KepecsLab/Bpod_r0_5/CAD/Mouse behavior box/Readme.txt

Note: This design for the mouse behavior box is undergoing validation.
It will almost certainly be revised many times in the coming year. A bill of materials is available on the Bpod wiki. JS, June 2015
