KepecsLab/Bpod_r0_5/CAD/Ports/Mouse nosepoke/Readme.txt

Note: The design for the mouse poke is optimized for 3-d printing.
However, mice eat PLA and possibly ABS. A future revision will feature a re-design optimized for machining. A bill of materials is available on the Bpod wiki. JS, June 2015
