KepecsLab/Bpod_r0_5/Bpod System Files/Internal Functions/Graphics/Bitmap/GrayBG.jpg

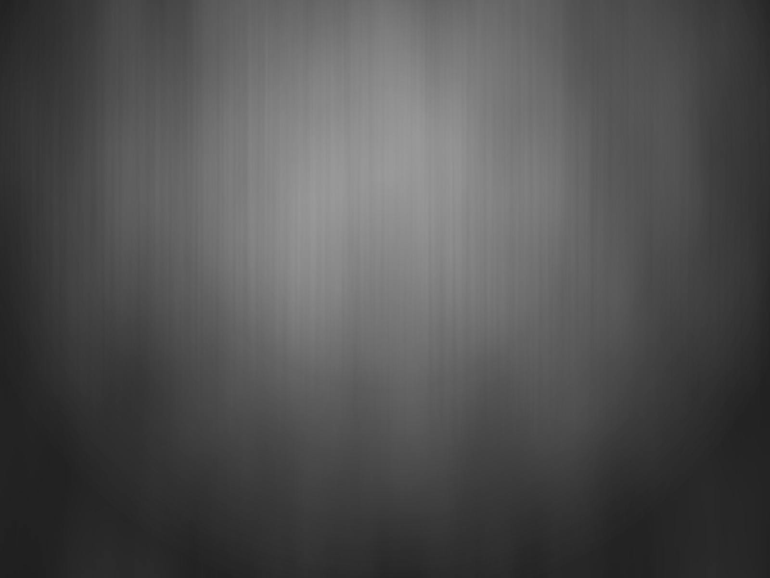
Bpod System Files/Internal Functions/Graphics/Bitmap/GrayBG.jpg
