KepecsLab/Bpod_r0_5/Bpod System Files/Internal Functions/Graphics/Bitmap/RewardCalAddRecommends.bmp

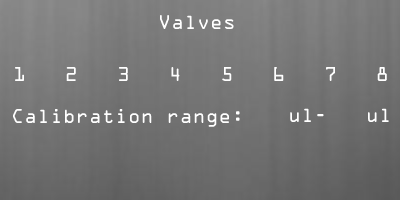
Bpod System Files/Internal Functions/Graphics/Bitmap/RewardCalAddRecommends.bmp
