KepecsLab/Bpod_r0_5/Bpod System Files/Internal Functions/Graphics/Bitmap/RewardCalEnterValue.bmp

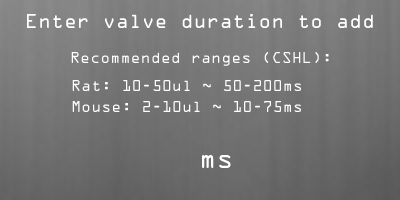
Bpod System Files/Internal Functions/Graphics/Bitmap/RewardCalEnterValue.bmp
