KepecsLab/Bpod_r0_5/Bpod System Files/Internal Functions/Graphics/Bitmap/SettingsMenuBG.bmp

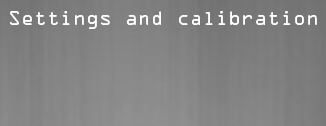
Bpod System Files/Internal Functions/Graphics/Bitmap/SettingsMenuBG.bmp
