KepecsLab/Bpod_r0_5/Bpod System Files/Internal Functions/Graphics/Bitmap/sm_bg.bmp

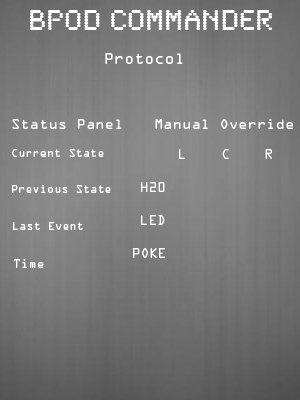
Bpod System Files/Internal Functions/Graphics/Bitmap/sm_bg.bmp
