KepecsLab/Bpod_r0_5/CAD/PCB/BpodDevice/Mouse.bmp

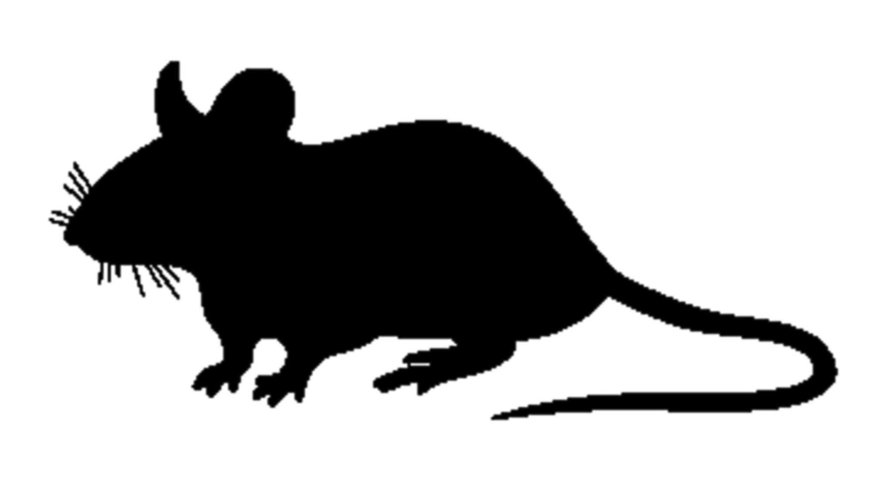
CAD/PCB/BpodDevice/Mouse.bmp
