KepecsLab/Bpod_r0_5/CAD/Ports/Lickometer/Lickometer.jpg

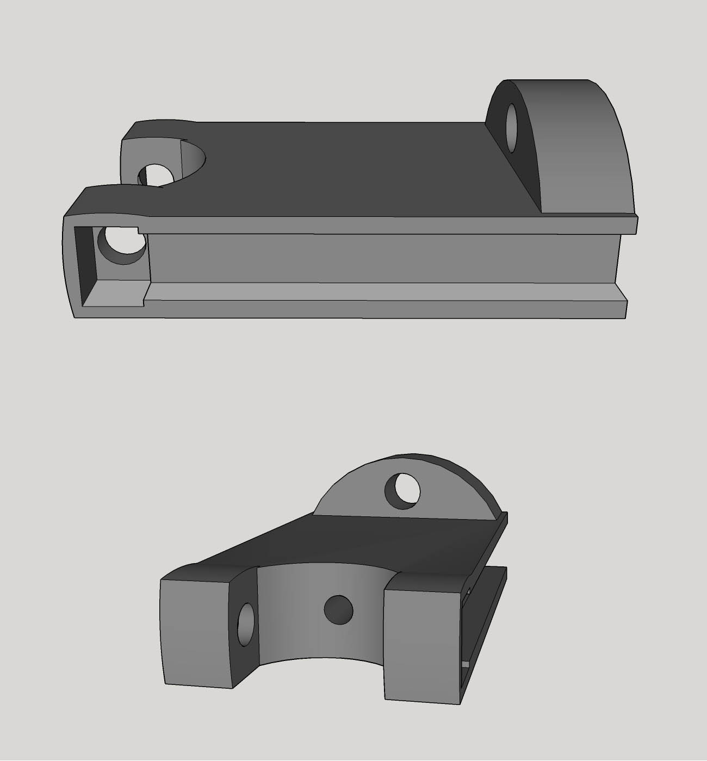
CAD/Ports/Lickometer/Lickometer.jpg
