KepecsLab/Bpod_r0_5/CAD/Mouse behavior box/2D DXF Laser Cut/Laser_Clear_3mm.dxf

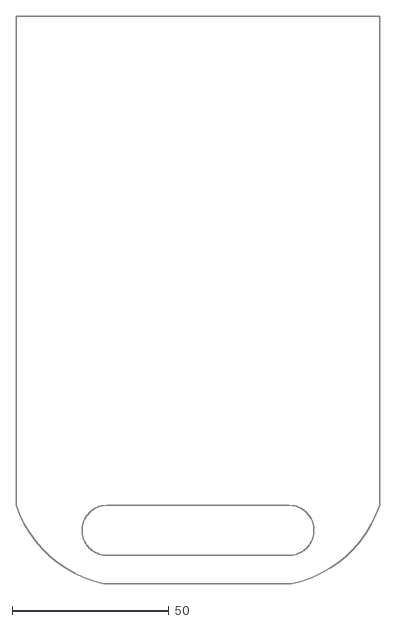
[picture p20: CAD file, 2015-06-29]
CAD/Mouse behavior box/2D DXF Laser Cut/Laser_Clear_3mm.dxf
116.0 x 181.0
