KepecsLab/Bpod_r0_5/CAD/Mouse behavior box/3D STL Print/MouseBox_3dPrint_Base.stl

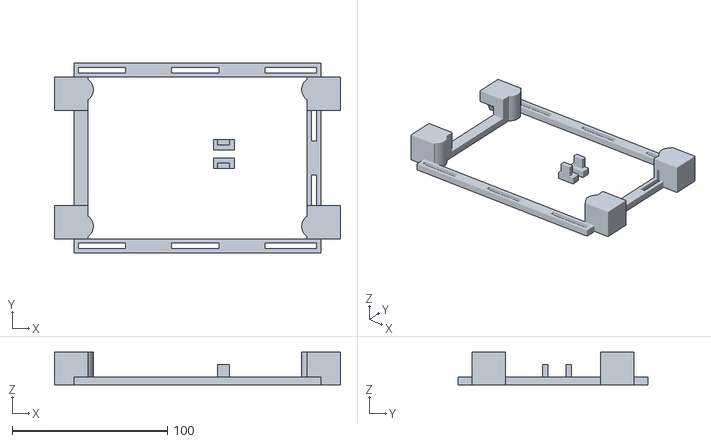
[picture p21: CAD file, 2015-06-29]
CAD/Mouse behavior box/3D STL Print/MouseBox_3dPrint_Base.stl
184.0 x 122.0 x 21.0
