KepecsLab/Bpod_r0_5/CAD/Ports/Lickometer/Lickometer.stl

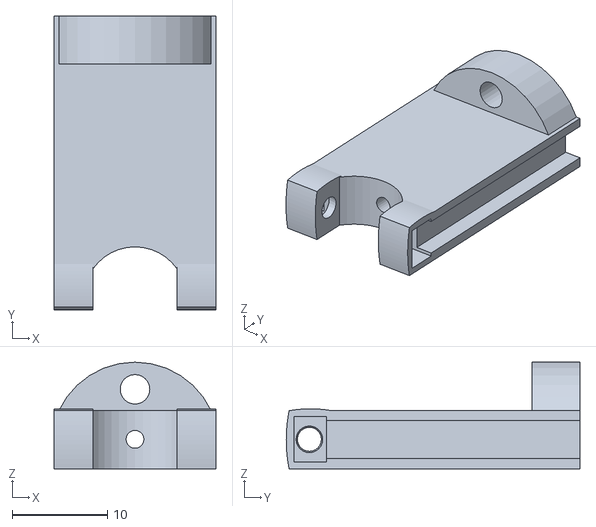
[picture p22: CAD file, 2014-11-01]
CAD/Ports/Lickometer/Lickometer.stl
17.0 x 30.8 x 11.2
