KepecsLab/Bpod_r0_5/CAD/Mouse behavior box/2D DXF Laser Cut/Laser_White_3mm.dxf

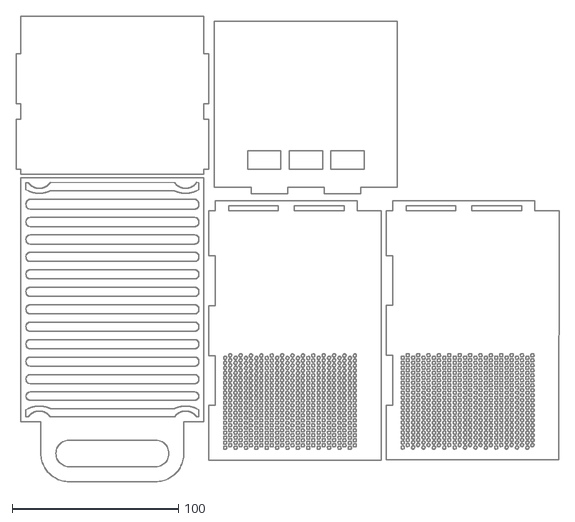
[picture p23: CAD file, 2015-06-29]
CAD/Mouse behavior box/2D DXF Laser Cut/Laser_White_3mm.dxf
326.7 x 280.0
