KepecsLab/Bpod_r0_5/CAD/Mouse behavior box/3D STL Print/MouseBox_3dPrint_Top.stl

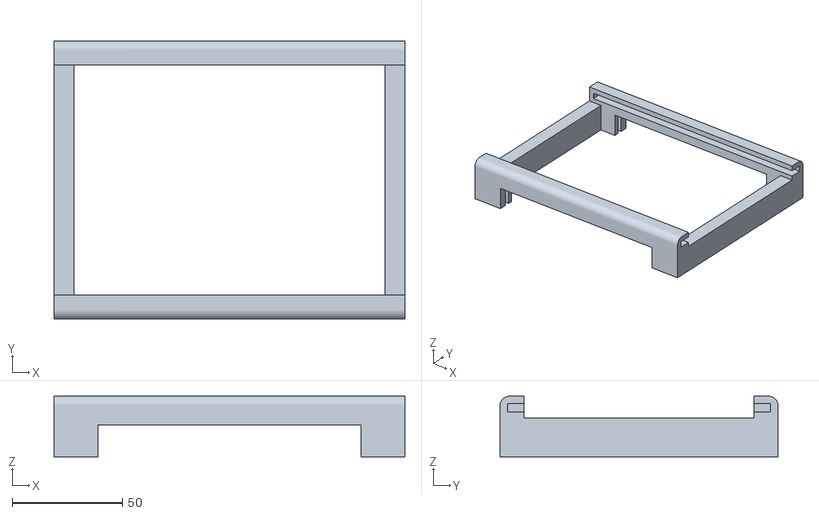
[picture p24: CAD file, 2015-06-29]
CAD/Mouse behavior box/3D STL Print/MouseBox_3dPrint_Top.stl
159.0 x 126.1 x 27.5
