KepecsLab/Bpod_r0_5/(list of files, cad)

Other CAD files:
CAD/Accessories/Open Ephys sync board/OpenEphysSyncBoardMount.skp
CAD/Ports/Lickometer/Lickometer.skp
CAD/Ports/Mouse nosepoke/Mousepoke_3dprint_PLA_Divider.skp
CAD/Ports/Mouse nosepoke/Mousepoke_3dprint_PLA_cover.skp
CAD/Ports/Mouse nosepoke/Mousepoke_3dprint_PLA_port.skp
CAD/Ports/Mouse nosepoke/Mousepoke_3dprint_PLA_sheath.skp
CAD/Ports/Mouse nosepoke/Mousepoke_InterfaceBoardMount.skp
