KepecsLab/Bpod_r0_5/CAD/PCB/MouseBoxPortBreakout/MouseBox_PortBreakout_r1.brd

## EAGLE design CAD/PCB/MouseBoxPortBreakout/MouseBox_PortBreakout_r1.brd (2015-07-06)

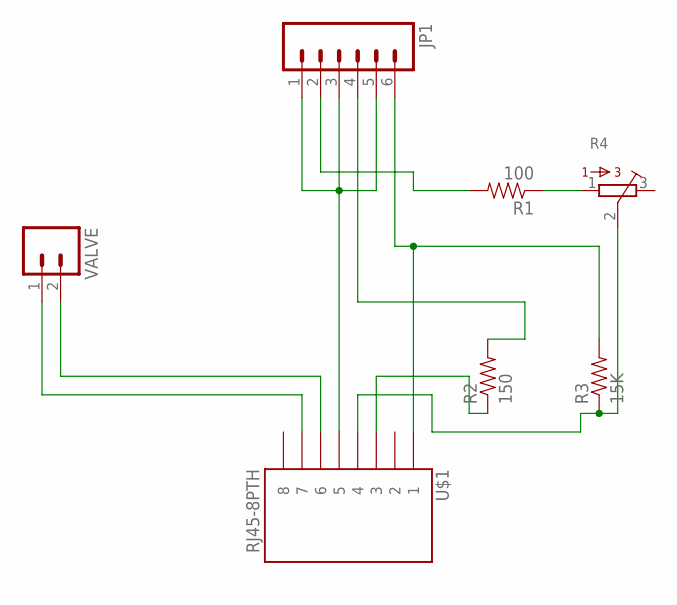
[picture p25: schematic MouseBox_PortBreakout_r1.sch]

Parts:
JP1: M063.5MM-6; SCREWTERMINAL-3.5MM-6
R1: 100; AXIAL-0.3
R2: 150; AXIAL-0.3
R3: 15K; AXIAL-0.3
R4: 3362R
U$1: RJ45-8PTH; RJ45-8
VALVE: M023.5MM_LOCK; SCREWTERMINAL-3.5MM-2_LOCK

Connections:
GND: JP1.1, JP1.3, JP1.5, U$1.5
unnamed: JP1.6, R3.P$2 (2), U$1.1
unnamed: R3.P$1 (1), R4.2, U$1.4
unnamed: JP1.2, R1.P$2 (2)
unnamed: U$1.6, VALVE.2
unnamed: U$1.7, VALVE.1
unnamed: JP1.4, R2.P$2 (2)
unnamed: R2.P$1 (1), U$1.3
unnamed: R1.P$1 (1), R4.1

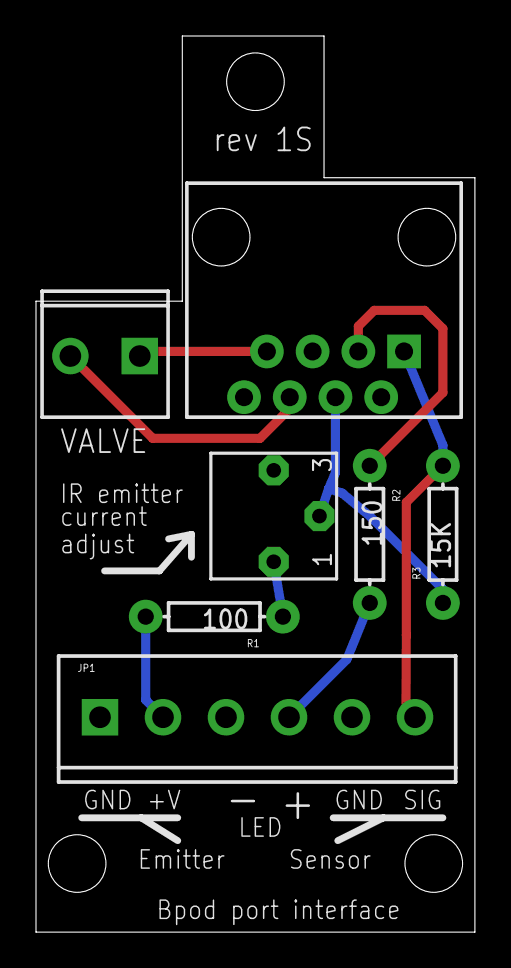
[picture p26: board MouseBox_PortBreakout_r1.brd from above]

Board: 2 copper layers, 24.4 x 49.8 mm, 7 parts (0 on the bottom side), 9 nets.
