KepecsLab/Bpod_r0_5/CAD/PCB/BpodDevice/BpodMainBoard_r0_5.brd

## EAGLE design CAD/PCB/BpodDevice/BpodMainBoard_r0_5.brd (2014-08-26)

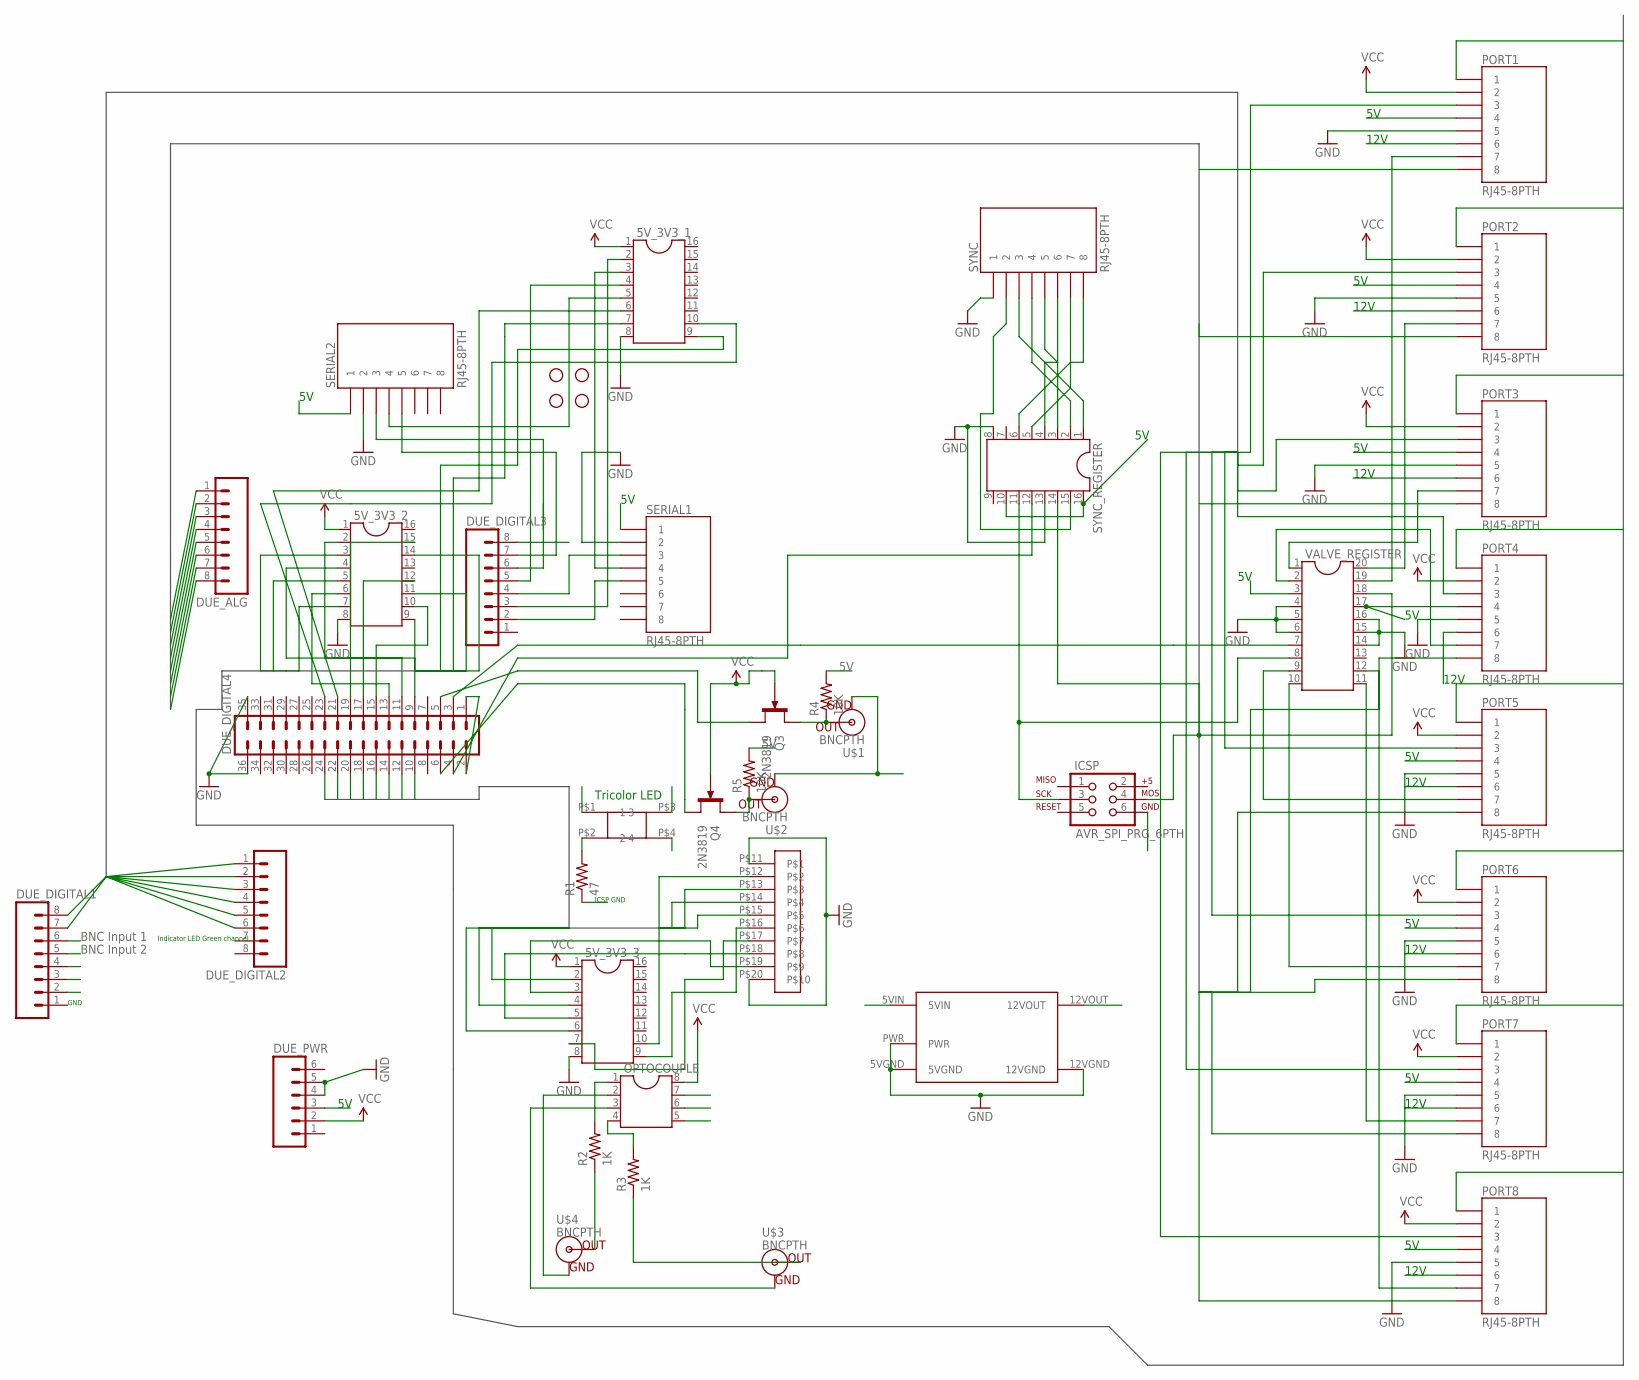
[picture p27: schematic BpodMainBoard_r0_5.sch]

Parts:
5V_3V3_1, 5V_3V3_2, 5V_3V3_3: DIL16
DUE_ALG: M081X08; 1X08
DUE_DIGITAL1, DUE_DIGITAL2, DUE_DIGITAL3: M081X08; 1X08
DUE_DIGITAL4: MA18-2
DUE_PWR: M06SIP; 1X06
ICSP: AVR_SPI_PRG_6PTH; 2X3
JP1, JP2, JP3, JP4: STAND-OFF
OPTOCOUPLE: DIL8; DIL08
PORT1, PORT2, PORT3, PORT4, PORT5, PORT6, PORT7, PORT8: RJ45-8PTH; RJ45-8
Q3, Q4: 2N3819; TO92F
R1: 47; AXIAL-0.3
R2, R3: 1K; AXIAL-0.3
R4, R5: 10K; AXIAL-0.3
SERIAL1, SERIAL2: RJ45-8PTH; RJ45-8
SYNC: RJ45-8PTH; RJ45-8
SYNC_REGISTER: DIL16
U$1, U$2, U$3, U$4: BNCPTH; BNC
U$5: TDK_LAMBDA_5V_TO_12V; TDK_LAMBDA_5V_12V
U$6: 10POS_SPRING_TERMINAL; 10POS_SCREW_TERMINAL
U$8: SQUARE_TRICOLOR_LED
VALVE_REGISTER: DIL20

Connections:
5V: DUE_DIGITAL4.1, DUE_DIGITAL4.2, DUE_PWR.3, PORT1.4, PORT2.4, PORT3.4, PORT4.4, PORT5.4, PORT6.4, PORT7.4, PORT8.4, R4.P$2 (2), R5.P$2 (2), SERIAL1.1, SERIAL2.1, SYNC_REGISTER.10, SYNC_REGISTER.16, U$5.5VIN, VALVE_REGISTER.3, VALVE_REGISTER.17
12V: PORT1.6, PORT2.6, PORT3.6, PORT4.6, PORT5.6, PORT6.6, PORT7.6, PORT8.6, U$5.12VOUT
ANALOG_BUS1: DUE_ALG.1, PORT1.8
ANALOG_BUS2: DUE_ALG.2, PORT2.8
ANALOG_BUS3: DUE_ALG.3, PORT3.8
ANALOG_BUS4: DUE_ALG.4, PORT4.8
ANALOG_BUS5: DUE_ALG.5, PORT5.8
ANALOG_BUS6: DUE_ALG.6, PORT6.8
ANALOG_BUS7: DUE_ALG.7, PORT7.8
ANALOG_BUS8: DUE_ALG.8, PORT8.8
BNCIN1: DUE_DIGITAL1.6, OPTOCOUPLE.7
BNCIN2: DUE_DIGITAL1.5, OPTOCOUPLE.6
DIGITAL_BUS1: 5V_3V3_2.3, PORT1.1
DIGITAL_BUS2: 5V_3V3_2.5, PORT2.1
DIGITAL_BUS3: 5V_3V3_2.7, PORT3.1
DIGITAL_BUS4: 5V_3V3_2.9, PORT4.1
DIGITAL_BUS5: 5V_3V3_2.11, PORT5.1
DIGITAL_BUS6: 5V_3V3_2.14, PORT6.1
DIGITAL_BUS7: 5V_3V3_1.7, PORT7.1
DIGITAL_BUS8: 5V_3V3_1.9, PORT8.1
DSUB_BUS1: 5V_3V3_3.2, DUE_DIGITAL4.10
DSUB_BUS2: 5V_3V3_3.4, DUE_DIGITAL4.12
DSUB_BUS3: 5V_3V3_3.6, DUE_DIGITAL4.14
DSUB_BUS4: 5V_3V3_3.10, DUE_DIGITAL4.16
DSUB_BUS5: DUE_DIGITAL4.18, U$6.P$15
DSUB_BUS6: DUE_DIGITAL4.20, U$6.P$14
DSUB_BUS7: DUE_DIGITAL4.22, U$6.P$13
DSUB_BUS8: DUE_DIGITAL4.24, U$6.P$12
GND: 5V_3V3_1.8, 5V_3V3_2.8, 5V_3V3_3.8, DUE_DIGITAL4.35, DUE_DIGITAL4.36, DUE_PWR.4, DUE_PWR.5, PORT1.5, PORT2.5, PORT3.5, PORT4.5, PORT5.5, PORT6.5, PORT7.5, PORT8.5, SERIAL1.2, SERIAL2.2, SYNC.1, SYNC_REGISTER.8, SYNC_REGISTER.13, U$5.5VGND, U$5.12VGND, U$5.PWR, U$6.P$11, U$6.P$20, VALVE_REGISTER.4, VALVE_REGISTER.5, VALVE_REGISTER.6, VALVE_REGISTER.14, VALVE_REGISTER.15, VALVE_REGISTER.16
ICSP_GND: ICSP.6, R1.P$1 (1)
LED1: DUE_DIGITAL1.4, U$8.P$3 (3)
LED2: DUE_DIGITAL1.3, U$8.P$4 (4)
LED3: DUE_DIGITAL3.8, U$8.P$1 (1)
LED_BUS1: DUE_DIGITAL1.7, PORT1.3
LED_BUS2: DUE_DIGITAL1.8, PORT2.3
LED_BUS3: DUE_DIGITAL2.1, PORT3.3
LED_BUS4: DUE_DIGITAL2.2, PORT4.3
LED_BUS5: DUE_DIGITAL2.3, PORT5.3
LED_BUS6: DUE_DIGITAL2.4, PORT6.3
LED_BUS7: DUE_DIGITAL2.5, PORT7.3
LED_BUS8: DUE_DIGITAL2.6, PORT8.3
unnamed: R2.P$1 (1), U$4.S (OUT)
unnamed: R3.P$1 (1), U$3.S (OUT)
unnamed: OPTOCOUPLE.1, R2.P$2 (2)
unnamed: OPTOCOUPLE.4, R3.P$2 (2)
unnamed: OPTOCOUPLE.2, U$4.GND
unnamed: OPTOCOUPLE.3, U$3.GND
unnamed: Q3.D, R4.P$1 (1), U$1.S (OUT)
unnamed: Q4.D, R5.P$1 (1), U$2.S (OUT)
unnamed: PORT1.7, VALVE_REGISTER.19
unnamed: PORT2.7, VALVE_REGISTER.20
unnamed: PORT3.7, VALVE_REGISTER.1
unnamed: PORT4.7, VALVE_REGISTER.2
unnamed: PORT5.7, VALVE_REGISTER.9
unnamed: PORT6.7, VALVE_REGISTER.10
unnamed: PORT7.7, VALVE_REGISTER.11
unnamed: PORT8.7, VALVE_REGISTER.12
unnamed: SYNC.2, SYNC_REGISTER.15
unnamed: SYNC.3, SYNC_REGISTER.1
unnamed: SYNC.4, SYNC_REGISTER.2
unnamed: DUE_DIGITAL4.3, VALVE_REGISTER.7
unnamed: SYNC.5, SYNC_REGISTER.3
unnamed: SYNC.6, SYNC_REGISTER.4
unnamed: SYNC.7, SYNC_REGISTER.5
unnamed: SYNC.8, SYNC_REGISTER.6
unnamed: R1.P$2 (2), U$8.P$2 (2)
unnamed: DUE_DIGITAL4.5, Q3.S
unnamed: DUE_DIGITAL4.4, SYNC_REGISTER.12
unnamed: DUE_DIGITAL4.6, Q4.S
unnamed: 5V_3V3_1.3, SERIAL1.4
unnamed: 5V_3V3_1.2, DUE_DIGITAL3.3
unnamed: DUE_DIGITAL3.4, SERIAL1.3
unnamed: 5V_3V3_1.5, SERIAL2.4
unnamed: 5V_3V3_1.4, DUE_DIGITAL3.5
unnamed: DUE_DIGITAL3.2, SERIAL1.5
unnamed: 5V_3V3_1.6, DUE_DIGITAL4.21
unnamed: DUE_DIGITAL3.6, SERIAL2.3
unnamed: 5V_3V3_1.10, DUE_DIGITAL4.23
unnamed: DUE_DIGITAL3.7, SERIAL2.5
unnamed: 5V_3V3_2.2, DUE_DIGITAL4.9
unnamed: 5V_3V3_2.4, DUE_DIGITAL4.11
unnamed: 5V_3V3_2.6, DUE_DIGITAL4.13
unnamed: 5V_3V3_2.10, DUE_DIGITAL4.15
unnamed: 5V_3V3_2.12, DUE_DIGITAL4.17
unnamed: 5V_3V3_2.15, DUE_DIGITAL4.19
unnamed: 5V_3V3_3.3, U$6.P$19
unnamed: 5V_3V3_3.5, U$6.P$18
unnamed: 5V_3V3_3.7, U$6.P$17
unnamed: 5V_3V3_3.9, U$6.P$16
SPI_CLK: ICSP.3, SYNC_REGISTER.11, VALVE_REGISTER.8
SPI_DATA: ICSP.4, SYNC_REGISTER.14, VALVE_REGISTER.18
UPPER_GND: DUE_DIGITAL1.2, OPTOCOUPLE.5, U$1.GND, U$2.GND
VCC: 5V_3V3_1.1, 5V_3V3_2.1, 5V_3V3_3.1, DUE_PWR.2, OPTOCOUPLE.8, PORT1.2, PORT2.2, PORT3.2, PORT4.2, PORT5.2, PORT6.2, PORT7.2, PORT8.2, Q3.G, Q4.G

Notes on the sheet:
12V
BNC Input 1
BNC Input 2
Indicator LED Green channel
Tricolor LED
ICSP GND
GND

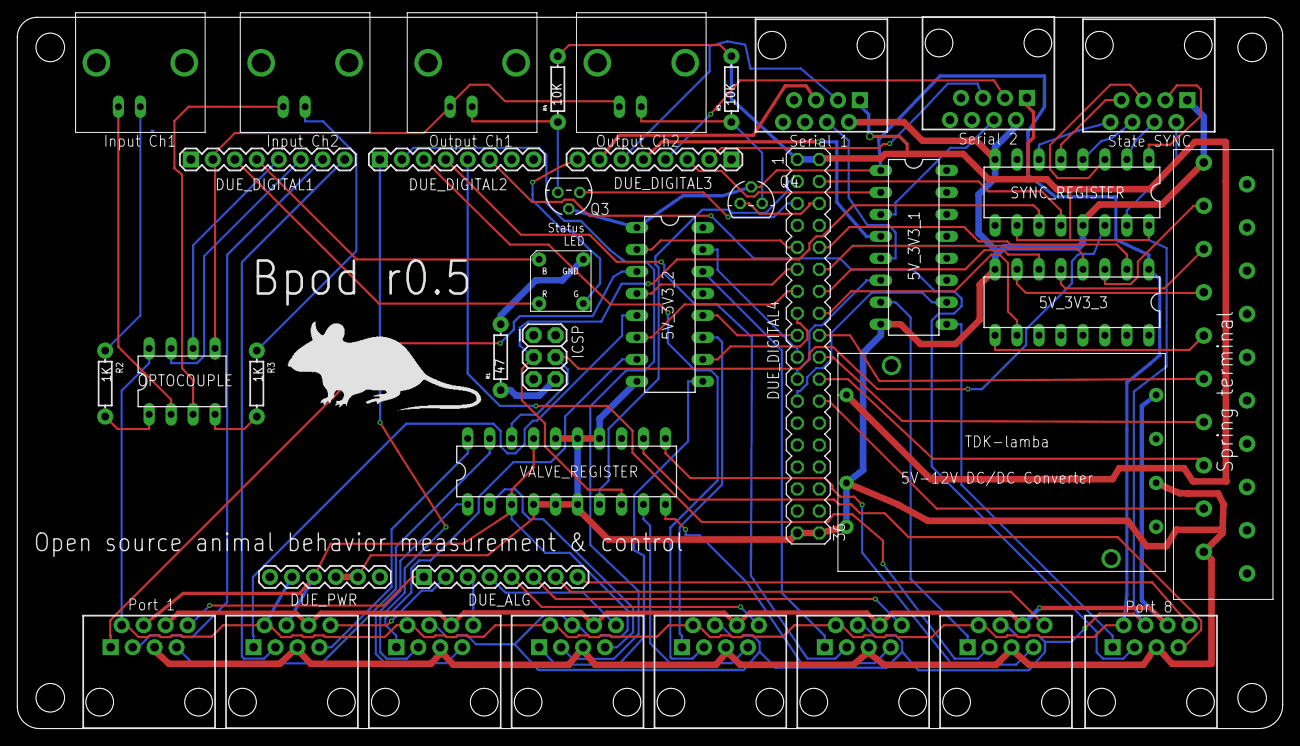
[picture p28: board BpodMainBoard_r0_5.brd from above]

Board: 2 copper layers, 146.3 x 82.2 mm, 43 parts (0 on the bottom side), 93 nets.

Other parts of the board:
U$7: MOUSELOGO
