KepecsLab/Bpod_r0_5/CAD/PCB/OpenEphysSync/io-board-Bpod.brd

## EAGLE design CAD/PCB/OpenEphysSync/io-board-Bpod.brd (2014-02-06)

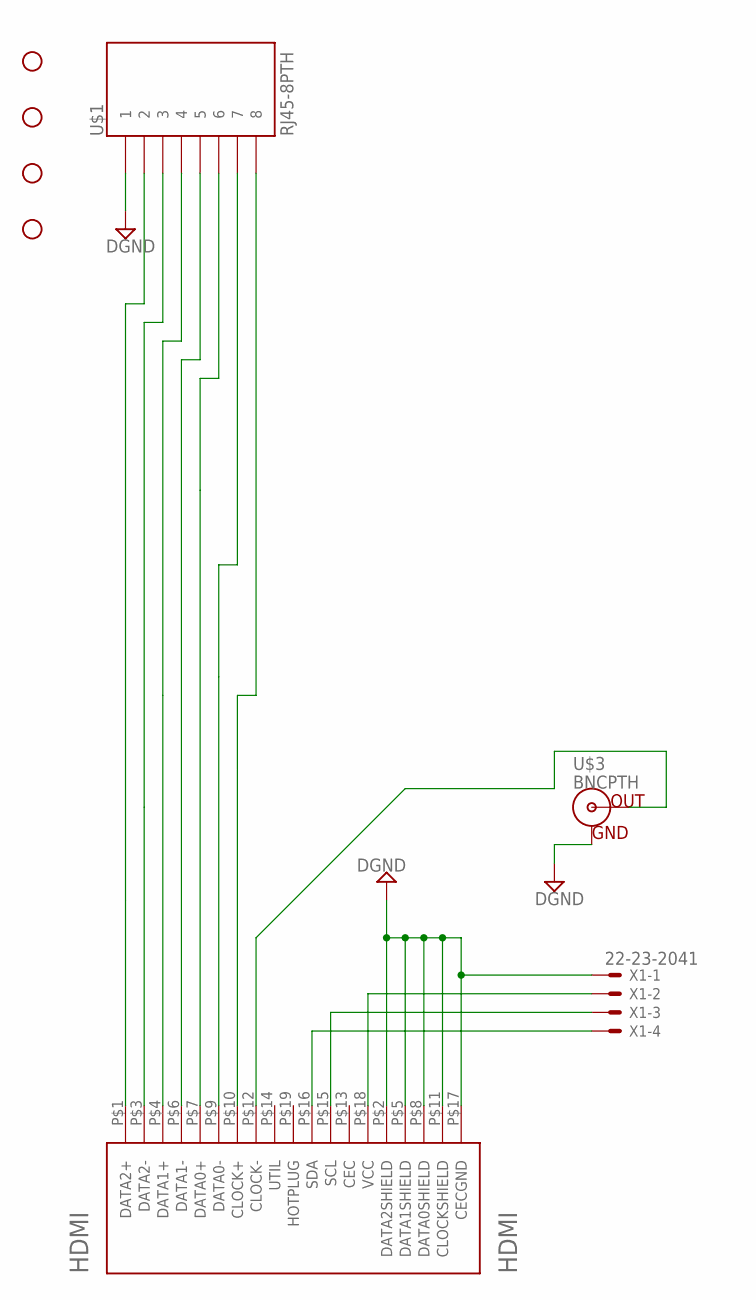
[picture p29: schematic io-board-Bpod.sch]

Parts:
HDMI: HDMI; HDMI_A
STANDOFF1, STANDOFF2, STANDOFF3, STANDOFF4: STAND-OFF
U$1: RJ45-8PTH; RJ45-8
U$3: BNCPTH; BNC
X1: 22-23-2041

Connections:
CH6: HDMI.P$9 (DATA0-), U$1.7
DGND: HDMI.P$2 (DATA2SHIELD), HDMI.P$5 (DATA1SHIELD), HDMI.P$8 (DATA0SHIELD), HDMI.P$11 (CLOCKSHIELD), HDMI.P$17 (CECGND), U$1.1, U$3.GND, X1.1
I2C_CLK: HDMI.P$15 (SCL), X1.3
I2C_DAT: HDMI.P$16 (SDA), X1.4
unnamed: HDMI.P$12 (CLOCK-), U$3.S (OUT)
unnamed: HDMI.P$4 (DATA1+), U$1.4
unnamed: HDMI.P$3 (DATA2-), U$1.3
unnamed: HDMI.P$1 (DATA2+), U$1.2
unnamed: HDMI.P$7 (DATA0+), U$1.6
unnamed: HDMI.P$10 (CLOCK+), U$1.8
unnamed: HDMI.P$6 (DATA1-), U$1.5
VCC: HDMI.P$18 (VCC), X1.2

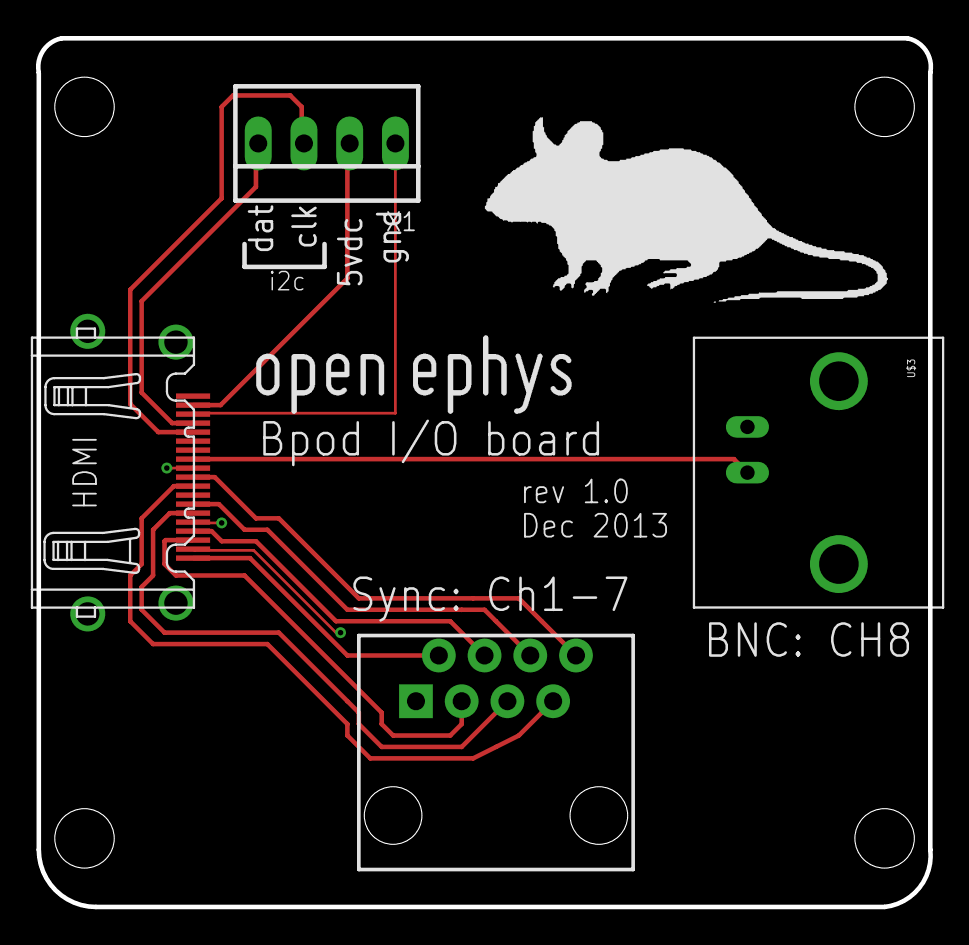
[picture p30: board io-board-Bpod.brd from above]

Board: 4 copper layers, 49.6 x 48.3 mm, 10 parts (0 on the bottom side), 12 nets.

Other parts of the board:
U$2: OPEN_EPHYS_LOGO
U$4: MOUSELOGO
