KepecsLab/Bpod_r0_5/CAD/PCB/BpodArduinoShield/Bpod_Serial_Shield_r1.brd

## EAGLE design CAD/PCB/BpodArduinoShield/Bpod_Serial_Shield_r1.brd (2014-02-06)

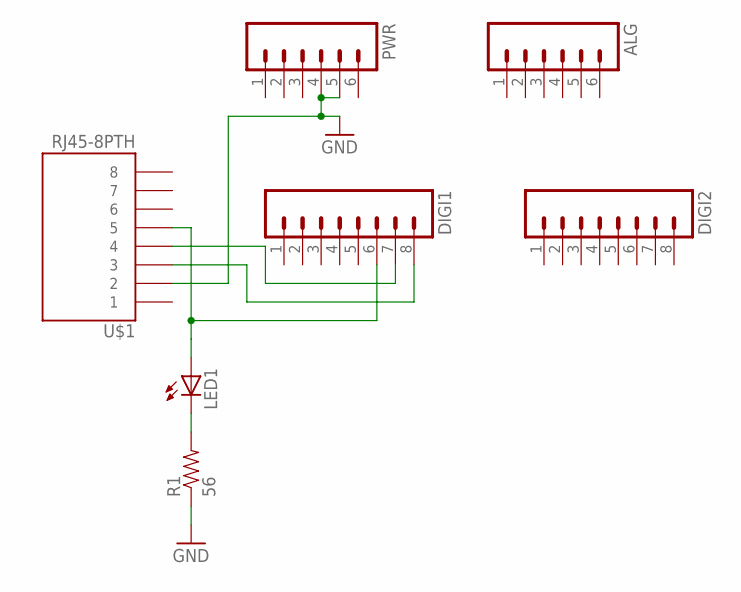
[picture p31: schematic Bpod_Serial_Shield_r1.sch]

Parts:
ALG: M06LONGPADS; 1X06_LONGPADS
DIGI1, DIGI2: M08LONGPADS; 1X08_LONGPADS
LED1: LED3MM
PWR: M06LONGPADS; 1X06_LONGPADS
R1: 56; AXIAL-0.3
U$1: RJ45-8PTH; RJ45-8

Connections:
GND: PWR.4, PWR.5, R1.P$1 (1), U$1.2
unnamed: DIGI1.8, U$1.3
unnamed: DIGI1.7, U$1.4
unnamed: DIGI1.6, LED1.A, U$1.5
unnamed: LED1.K (C), R1.P$2 (2)

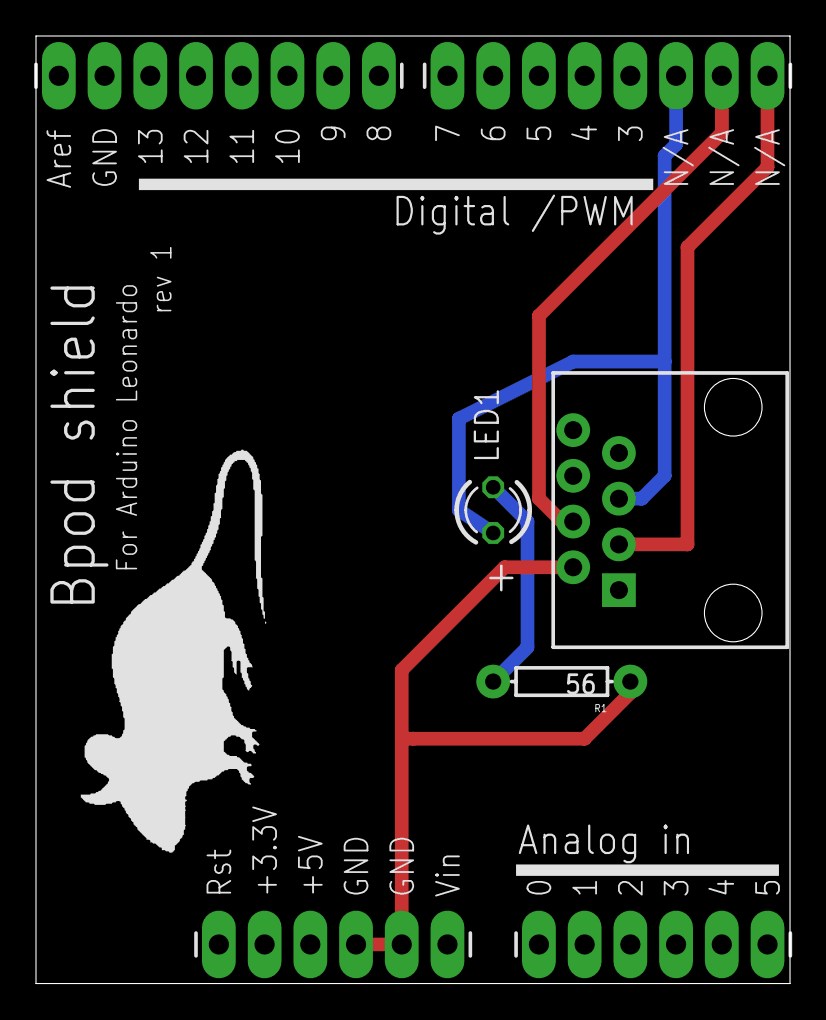
[picture p32: board Bpod_Serial_Shield_r1.brd from above]

Board: 4 copper layers, 41.9 x 52.6 mm, 8 parts (0 on the bottom side), 5 nets.

Other parts of the board:
U$2: MOUSELOGO
