KepecsLab/Bpod_r0_5/(commit log)

2014-07-01 Major update: -Integrates with PsychToolbox (if installed) for low latency serial and possible future use as a sound server -Adds sound support with Teensy Audio board, added as a hardware serial dev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
    [BpodMainBoard_r0_5.brd, BpodMainBoard_r0_5.sch, Bpod_PortBreakout_r1.brd, Bpod_PortBreakout_r1.sch, ValveMount_2valves.skp, ValveMount_2valves.stl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]
2014-07-28 -Integrated Bpod with PsychToolbox serial interface (if detected) for low latency -Added interface for closed loop feedback plugins, and an example plugin: a sound server using ASIO and PsychToolbox,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
    [Bpod_MainModule_0_5.ino, SerialBlinkServer.ino, SoundServer.ino, TeensySoundServer.ino]
2014-08-26 -Fixed bug with override command (crashed if used prior to uploading a state matrix) -Updated PCB design to eliminate a stray trace (did not affect function of prior revision)
    [BpodMainBoard_r0_5.brd]
2014-10-13 -Added license information to each code file -Added a hardware serial Ethernet client and firmware (to send text strings via Ethernet from the state machine using Arduino Leonardo + Bpod shield + Ard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
    [Bpod_MainModule_0_5.ino, SerialEthernetModule.ino, SoundServer.ino, TeensySoundServer.ino]
2014-11-01 -Updated firmware to fix 2 bugs: >After configuring low impedence inputs from the settings menu, Bpod would not return the unused channel status to 0, resulting in false events on the disconnected ch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
    [Lickometer.skp, Lickometer.stl]
2014-11-02 -Optimized BpodNotebook plugin for speed -Optimized ParameterGUI plugin for speed -Optimized OutcomePlot plugin for speed -Optimized AddTrialEvents for speed -Optimized liquid calibration and lookup 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
2014-11-14 Performance improvements: -Bpod now generates a blank state matrix on initialization and stores it in memory, so it doesn't have to be generated on each call to NewStateMatrix. -Improvements in RunSt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
2014-11-14 -Changed timer display on Bpod console - now shows trial start time (instead of "protocol time". -Removed parser from AddState - now all argument pairs must be listed in order (for efficiency) -Added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
2014-12-26 Added Bpod / Neuralynx sync adapter PCB design (tested) Removed outdated enclosure design files
    [BpodEnclosure_r0_5_0.dxf, BpodEnclosure_r0_5_1.dxf, BpodEnclosure_r0_5_2.dwg, BpodEnclosure_r0_5_2.dxf, BpodNlxSync.brd, BpodNlxSync.sch]
2015-03-13 -Added play/pause function. One line must be added to each protocol: HandlePauseCondition; (See example protocols for placement) -Added help button link to Wiki -Bug fixes for liquid calibration unde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
2015-06-29 -Fixed stereo sounds in Bpod emulator sound server -Added a new plugin for visualizing outcomes of non-sided tasks -Added support for triggering state changes from Bonsai -Fixed soft-code manual over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
    [Laser_Clear_3mm.dxf, Laser_White_3mm.dxf, Lickometer.skp, Lickometer.stl, MouseBox_3dPrint_Base.stl, MouseBox_3dPrint_Top.stl, Mousepoke_3dprint_PLA_cover.skp, Mousepoke_3dprint_PLA_port.skp]
2015-07-06 Added design for mousebox port interface board. Updated native graphics package
    [MouseBox_PortBreakout_r1.brd, MouseBox_PortBreakout_r1.sch, Mousepoke_3dprint_PLA_Divider.skp]
