KepecsLab/Bpod_r0_5/(notices)

Notices in the files:
Bpod Firmware/Bpod_MainModule_0_5/Bpod_MainModule_0_5.ino:
This program is free software: you can redistribute it and/or modify
it under the terms of the GNU General Public License as published by
the Free Software Foundation, version 3.
parts and their libraries:
SparkFun-Passives: Licensing: CC v3.0 Share-Alike You are welcome to use this library for commercial purposes.
SparkFun-Resistors: Licensing: Creative Commons ShareAlike 4.0 International - https://creativecommons.org/licenses/by-sa/4.0
